circuitsmiles/ai-chat-bot-v0.2/circuit_diagram_fritz.png

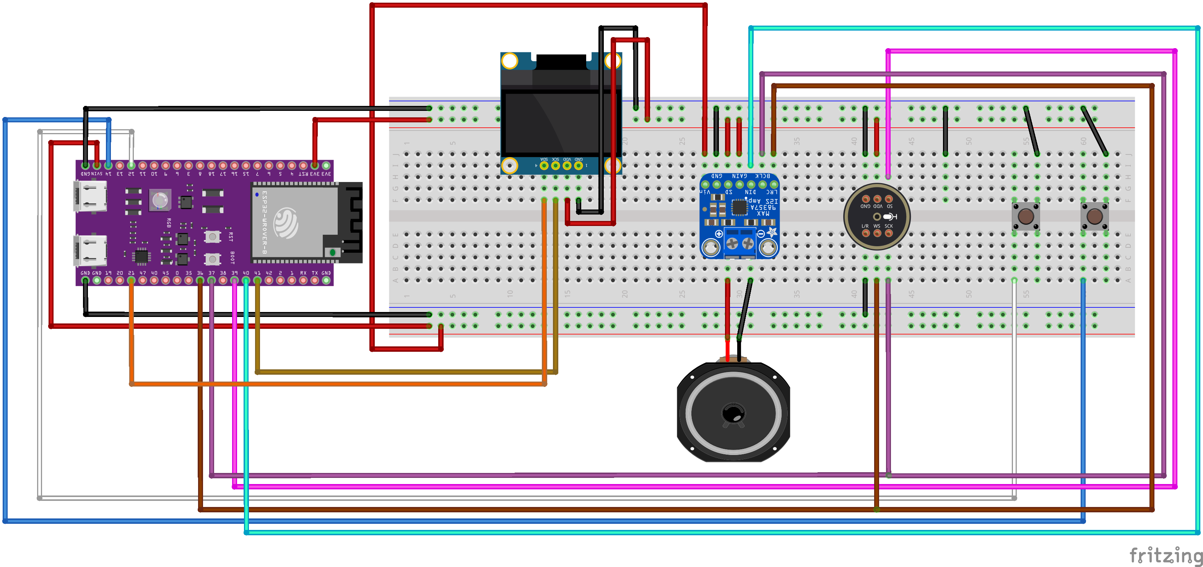
circuit_diagram_fritz.png
